medo64/UsbAmps/(list of files, drawings)

Other design files:
Hardware/Board/UsbAmps [CL].dip
Hardware/Board/UsbAmps [CR].dip
