medo64/UsbAmps/Firmware/Source/measure.h

#ifndef MEASURE_H
#define	MEASURE_H

#include <stdint.h>


void measure_init();
void measure_reinit();

uint16_t measure_getVoltage_1m();
uint16_t measure_getCurrent_1m();
uint16_t measure_getRawCurrent();

#endif
