medo64/UsbAmps/Firmware/Source/lcd.h

#ifndef LCD_H
#define	LCD_H

void lcd_init();
void lcd_clear();

void lcd_writeCalibration();
void lcd_writeError();
void lcd_writeLoading();
void lcd_writeHighPower();
void lcd_writeStatsReset();
void lcd_writeAll();
void lcd_writeNoValue();

void lcd_writeValue(uint16_t value_1m);
void lcd_writeMilliValue(uint16_t value_1m);
void lcd_writeUnitAndType(uint8_t unitIndex, uint8_t typeIndex);

#endif
