medo64/UsbAmps/(commit log)

2013-02-04 Initial commit.
    [UsbAmps [A].dip]
2013-02-22 Fixed pinout for U PIC16F1934 (TQFP-44).
    [UsbAmps [A].dip]
2013-02-22 Refactoring board in order to avoid 3V3 voltage regulator.
    [UsbAmps [A].dip]
2013-02-23 Connected shield.
    [UsbAmps [A].dip]
2013-02-24 Refactoring board a bit.
    [UsbAmps [A].dip]
2013-02-24 Refactoring bear image.
    [UsbAmps [A].dip]
2013-02-24 Refactoring a bit.
    [UsbAmps [A].dip]
2013-02-24 Added second capacitive bear.
    [UsbAmps [A].dip]
2013-02-24 Redesigned bears a bit.
    [UsbAmps [A].dip]
2013-03-14 Disabling solder mask for part of GND pour.
    [UsbAmps [A].dip]
2013-03-15 Adding release.
    [UsbAmps [A1308].dip]
2013-03-15 Removing switch and making board a bit shorter.
    [UsbAmps [A].dip]
2013-03-15 Adding support for min/max reset.
    [app.c]
2013-03-16 Fixed botched ADC reading.
    [measure.c]
2013-03-16 Refactoring button detection.
2013-03-16 Added notch to LCD pattern and via refactoring.
    [UsbAmps [A].dip]
2013-03-16 Refactoring board to use lower voltage reference.
    [UsbAmps [A].dip, UsbAmps [B].dip]
2013-03-16 Adjusting silk screen.
    [UsbAmps [B].dip]
2013-03-16 Removing old release.
    [UsbAmps [A1308].dip]
2013-03-16 Moving buttons around.
    [UsbAmps [B].dip]
2013-03-17 Added offset current and voltage.
2013-04-02 Refactoring vias.
    [UsbAmps [B].dip]
2013-04-06 Slight via move.
    [UsbAmps [B].dip]
2013-04-07 Changing unit now reset min/max selection.
    [app.c]
2013-04-07 Removing binaries.
    [UsbAmps [A1308].dip]
2013-04-07 Changing unit now reset min/max selection (from B).
    [app.c]
2013-04-07 Leading zero is shown for values larger than 99 mA.
2013-04-07 Leading zero is shown for values larger than 99 mA (from B).
2013-04-08 Voltage and power are always displayed in 10 milli units (e.g. 0.01).
2013-04-25 Added left version.
    [UsbAmps [B].dip, UsbAmpsL [B].dip, UsbAmpsR [B].dip]
2013-05-27 Added calibration.
2013-09-02 Fixing ungrounded DP2.
    [UsbAmpsL [B].dip, UsbAmpsR [B].dip]
2013-09-02 Preparing for a new release (B1335).
    [UsbAmpsL [B].dip, UsbAmpsR [B].dip]
2013-09-02 Added option to show milliamps all the way to 1 A.
2013-11-17 Connected DP2 as a segment.
    [UsbAmpsL [B].dip, UsbAmpsR [B].dip]
2013-12-06 Connected DP2 to COM. Thanks Erwin!
    [UsbAmps [BL].dip, UsbAmps [BR].dip, UsbAmpsL [B].dip, UsbAmpsR [B].dip]
2013-12-06 Refactoring button names.
2013-12-06 Refactoring calibration.
2013-12-09 Added D-line MOSFET.
    [UsbAmps [BL].dip, UsbAmps [BR].dip, UsbAmps [CL].dip, UsbAmps [CR].dip]
2013-12-18 Fixing up calibration.
2013-12-18 Refactoring stats reset (moved to inner long-press).
    [app.c, lcd.c, lcd.h]
2014-01-04 Adjusting calibration and showing all segments on programming.
2014-06-26 Added basic capacity support.
2014-06-26 Added capacity average for last 10 seconds.
2014-09-16 Replacing 10K resistor with 2K2.
    [UsbAmps [CL].dip, UsbAmps [CR].dip]
2014-09-19 Added optional backlight.
    [UsbAmps [CL].dip, UsbAmps [CR].dip]
2014-11-10 Hi-power mode allows for Charging Downstream Port instead of Dedicated Charger Port.
2014-11-14 High power modes are on both buttons now.
2014-11-15 Changed segments to spell CDP and DCP on Hi-Power mode.
2014-11-16 Swapped button long-presses so that min/max reset is on outer button.
    [app.c]
2014-12-25 Getting parts in order.
    [UsbAmps [CL].dip, UsbAmps [CR].dip]
2014-12-26 Modifying backlight. Same diffuser can be used on both CL and CR.
    [UsbAmps [CL].dip, UsbAmps [CR].dip]
2014-12-26 Added explanation for L and R boards.
2014-12-28 Added GND test points.
    [UsbAmps [CL].dip, UsbAmps [CR].dip]
2015-01-01 Fixed DRC rules for 8 mil.
    [UsbAmps [CL].dip, UsbAmps [CR].dip]
2015-01-18 Not waiting forever for buttons to be relased on startu.
2015-01-18 Increased calibration tolerance a bit.
    [calibrate.c]
2016-05-07 Updated version with new domain.
    [UsbAmps [CL].dip, UsbAmps [CR].dip]
2016-05-26 Removed bare GND pads.
    [UsbAmps [CL].dip, UsbAmps [CR].dip]
2017-05-28 Changed bear icon.
    [UsbAmps [CL].dip, UsbAmps [CR].dip]
2017-06-03 Adjusted icon.
    [UsbAmps [CL].dip, UsbAmps [CR].dip]
